asmodeus812/pillzmod/pcb-split/placement.png

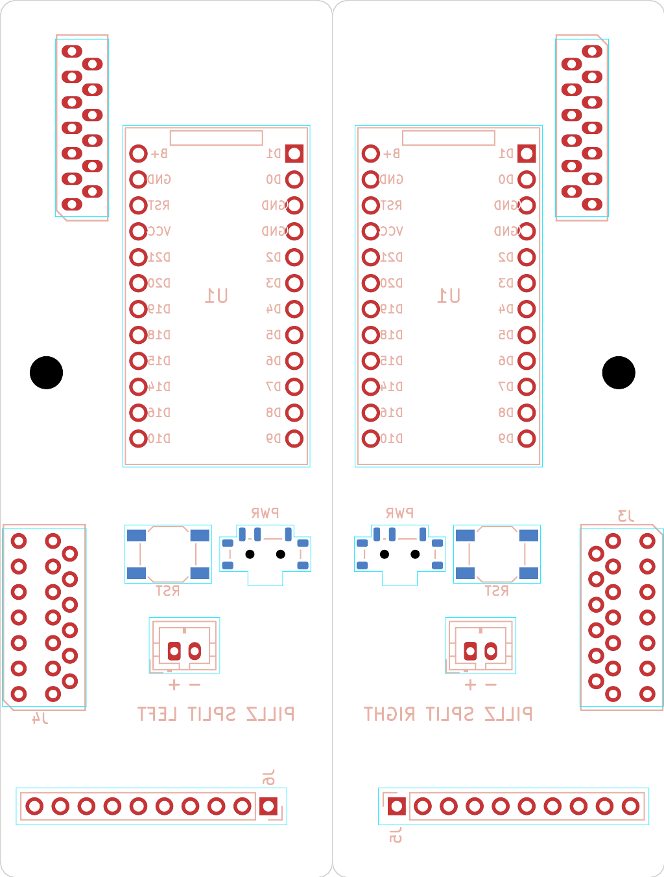
pcb-split/placement.png
