asmodeus812/pillzmod/pcb-split/routed.png

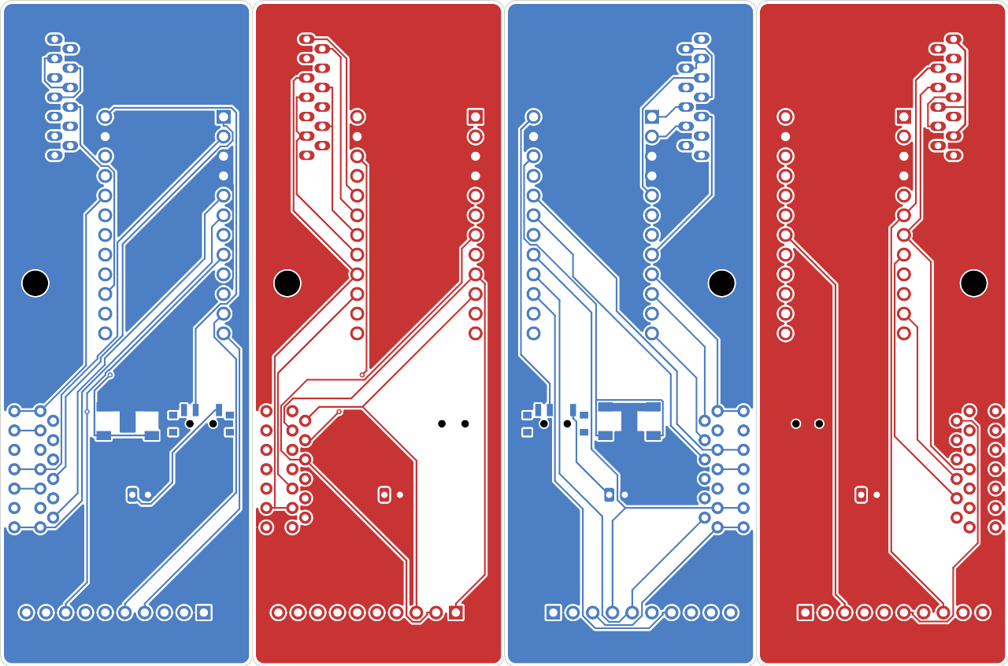
pcb-split/routed.png
