asmodeus812/pillzmod/pcb-split/parts-links.md

# Parts links (both halves, without the nice!nano, plus replacement cables)

Search links unless marked "product". Quantities are for both halves.

nice!nano sockets: one full 1x12 strip per side of each controller (4 strips),
plus 24 thin round male pins per controller (48). Mill-Max 315 low-profile
sockets take round pins of about 0.4-0.6 mm; square header pins don't fit.
3320-0-00-15-00-00-03-0 is the usual matching pin (unverified, check datasheet).

## DigiKey DE

Molex 39-53-2135 vertical, function row J1/J2 (x2): https://www.digikey.de/en/products/result?keywords=0039532135
Molex 39-53-2134 right angle, key well J3/J4 (x2): https://www.digikey.de/en/products/result?keywords=0039532134
JST B2B-PH-K-S (x2, product): https://www.digikey.de/en/products/detail/jst-sales-america-inc/B2B-PH-K-S/926611
Alps SKQGABE010 (x2): https://www.digikey.de/en/products/result?keywords=SKQGABE010
Mill-Max 315-43-112-41-003000 1x12 female socket strip (x4): https://www.digikey.de/en/products/result?keywords=315-43-112-41-003000
Mill-Max 3320-0-00-15-00-00-03-0 male pin, sold singly (x48): https://www.digikey.de/en/products/result?keywords=3320-0-00-15-00-00-03-0
1x10 pin header 2.54mm (x2): https://www.digikey.de/en/products/result?keywords=1x10%20pin%20header%202.54mm%20straight
C&K PCM12SMTR power switch (x2, product): https://www.digikey.de/en/products/detail/c-k/PCM12SMTR/1640112

## TME

Molex 39-53-2135 vertical, function row J1/J2 (x2): https://www.tme.eu/en/katalog/?search=39-53-2135
Molex 39-53-2134 right angle, key well J3/J4 (x2): https://www.tme.eu/en/katalog/?search=39-53-2134
JST B2B-PH-K-S (x2): https://www.tme.eu/en/katalog/?search=B2B-PH-K-S
Alps SKQGABE010 (x2): https://www.tme.eu/en/katalog/?search=SKQGABE010
Mill-Max 315-43-112-41-003000 1x12 female socket strip (x4): https://www.tme.eu/en/katalog/?search=315-43-112-41-003000
Mill-Max 3320-0-00-15-00-00-03-0 male pin, sold singly (x48): https://www.tme.eu/en/katalog/?search=3320-0-00-15-00-00-03-0
1x10 pin header 2.54mm (x2): https://www.tme.eu/en/katalog/?search=1x10%20pin%20header%202.54
C&K PCM12SMTR power switch (x2): https://www.tme.eu/en/katalog/?search=PCM12SMTR

## Mouser DE

Molex 39-53-2135 vertical, function row J1/J2 (x2): https://www.mouser.de/c/?q=0039532135
Molex 39-53-2134 right angle, key well J3/J4 (x2): https://www.mouser.de/c/?q=0039532134
JST B2B-PH-K-S (x2): https://www.mouser.de/c/?q=B2B-PH-K-S
Alps SKQGABE010 (x2): https://www.mouser.de/c/?q=SKQGABE010
Mill-Max 315-43-112-41-003000 1x12 female socket strip (x4): https://www.mouser.de/c/?q=315-43-112-41-003000
Mill-Max 3320-0-00-15-00-00-03-0 male pin, sold singly (x48): https://www.mouser.de/c/?q=3320-0-00-15-00-00-03-0
1x10 pin header 2.54mm (x2): https://www.mouser.de/c/?q=1x10%20header%202.54mm
C&K PCM12SMTR power switch (x2): https://www.mouser.de/c/?q=PCM12SMTR

## Farnell

Molex 39-53-2134 right angle, key well J3/J4 (x2, product): https://it.farnell.com/en-IT/molex-partner-stock/39-53-2134/fpc-conn-r-a-rcpt-13pos-1row-1/dp/4231522

## RS Components

Molex 39-53-2134 right angle, key well J3/J4 (x2, product): https://uk.rs-online.com/web/p/fpc-connectors/6704301

## Cables: key well / function row (13-pin flat flex, 1.25 mm pitch)

Only needed if the damaged flex unplugs at both ends; on the Advantage 2 the key
well flex is normally part of the key well. Measure the old one first: length,
and whether the contacts are on the same side at both ends (Type A) or opposite
sides (Type D). DigiKey lists 15168-xx13 as "top on both sides" = check before buying.
DigiKey .de links below are built from the product numbers seen on other DigiKey regions.

Molex 0151680813, 13 pos, 2 in / 50.8 mm (DigiKey, product): https://www.digikey.de/en/products/detail/molex/0151680813/4426889
Molex 0151680815, 13 pos, 3 in / 76.2 mm (DigiKey, product): https://www.digikey.de/en/products/detail/molex/0151680815/4143332
Molex 0151680821, 13 pos, 6 in / 152.4 mm (DigiKey, product): https://www.digikey.de/en/products/detail/molex/0151680821/4426892
Molex 151680813 product page (drawing, contact type): https://www.molex.com/en-us/products/part-detail/151680813
Molex 15168 13 pos, all lengths (Mouser): https://www.mouser.de/c/?q=15168%2013%20position
1.25 mm 13 pin FFC, all brands (TME): https://www.tme.eu/en/katalog/?search=FFC%201.25%2013

## Cables: thumb clusters (10-wire, 2.54 mm, single-row 1x10 both ends)

Pillz thumb PCB uses a 1x10 single-row header, not 2x5 IDC. Either a ready
10-wire Dupont female-female ribbon (peel 10 off a 40-wire strip) or KF2510
housings + crimp pins + ribbon. 10 cm is enough (upstream says >= 50 mm).

Dupont jumper ribbon F-F 10 cm (Botland): https://botland.com.pl/en/search?s=jumper%20wires%20female%20female%2010cm
Dupont jumper ribbon F-F 10 cm (Reichelt): https://www.reichelt.de/index.html?ACTION=446&SEARCH=jumper%20female%20female%2010cm
1x10 Dupont housing 2.54 mm (TME): https://www.tme.eu/en/katalog/?search=1x10%20housing%202.54
KF2510-10 housing (TME): https://www.tme.eu/en/katalog/?search=KF2510
1x10 female-female jumper 2.54 mm (DigiKey): https://www.digikey.de/en/products/result?keywords=jumper%20wire%20female%20female%2010%20position%202.54
