asmodeus812/pillzmod/pcb-split/right/pillz_split_right.kicad_pcb

## KiCad design pcb-split/right/pillz_split_right.kicad_pcb (2026-10-31)

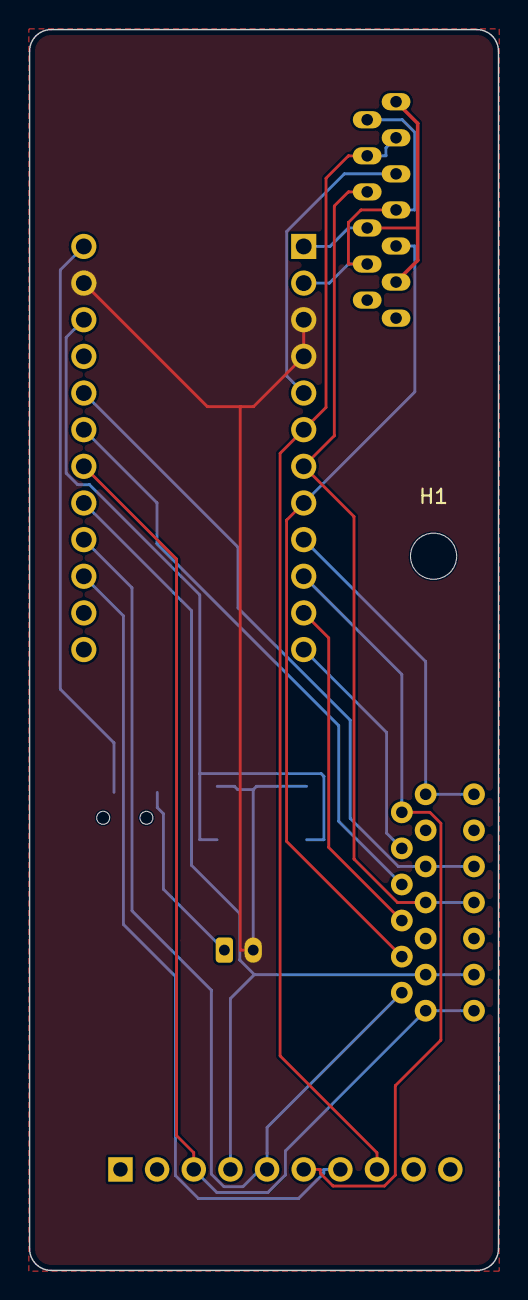
[picture p5: board pillz_split_right.kicad_pcb from above]

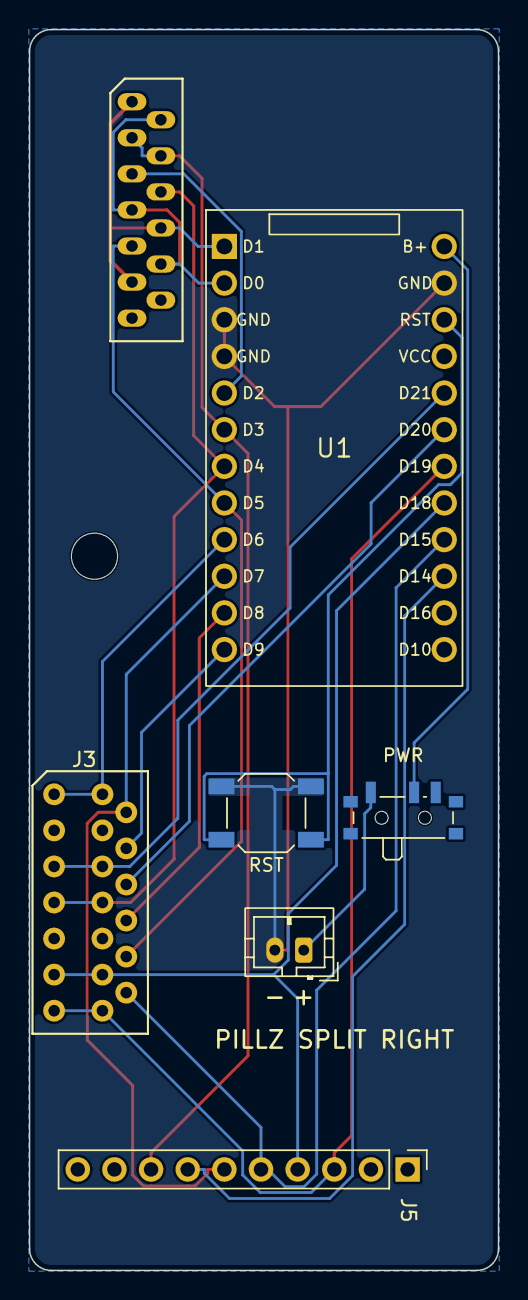
[picture p6: board pillz_split_right.kicad_pcb from below]

Board: 2 copper layers, 32.5 x 86.0 mm, 8 parts (7 on the bottom side), 20 nets.

Parts:
H1: MountingHole_3.2mm_M3
J1: Conn_01x13; Molex_0039532135
J3: Conn_01x13; Molex_039532134
J5: Conn_01x10; PinHeader_1x10_PillzThumb
J7: JST_PH_B2B-PH-K_1x02_P2.00mm_Vertical
SW1: SW_SPST_SKQG_WithoutStem
SW2: SW_SPDT_PCM12
U1: nice!nano v2; nice_nano_v2

Connections:
B+: SW2.2, U1.24
BAT+: J7.1, SW2.1
COL_0: J3.4, U1.12
COL_1: J3.5, U1.20
COL_2: J3.6, U1.19
COL_3: J1.6, J3.7, U1.7
COL_4: J1.9, J3.10, U1.8
COL_5: J1.3, J1.4, J5.8, U1.6
COL_6: J5.7, U1.15
GND: J7.2, SW1.2, U1.3, U1.4, U1.23
ROW_6: J3.13, J5.3, U1.18
ROW_7: J3.11, J5.4, U1.17
ROW_8: J3.12, J5.5, U1.16
ROW_9: J3.2, J5.6, U1.10
ROW_10: J3.1, U1.9
ROW_11: J3.8, U1.11
ROW_12: J1.5, U1.5
ROW_13: J1.1, J1.8, J1.11, U1.1
ROW_14: J1.2, J1.7, J1.10, U1.2
RST: SW1.1, U1.22
