asmodeus812/pillzmod/pcb-split/left/pillz_split_left.kicad_pcb

## KiCad design pcb-split/left/pillz_split_left.kicad_pcb (2026-10-31)

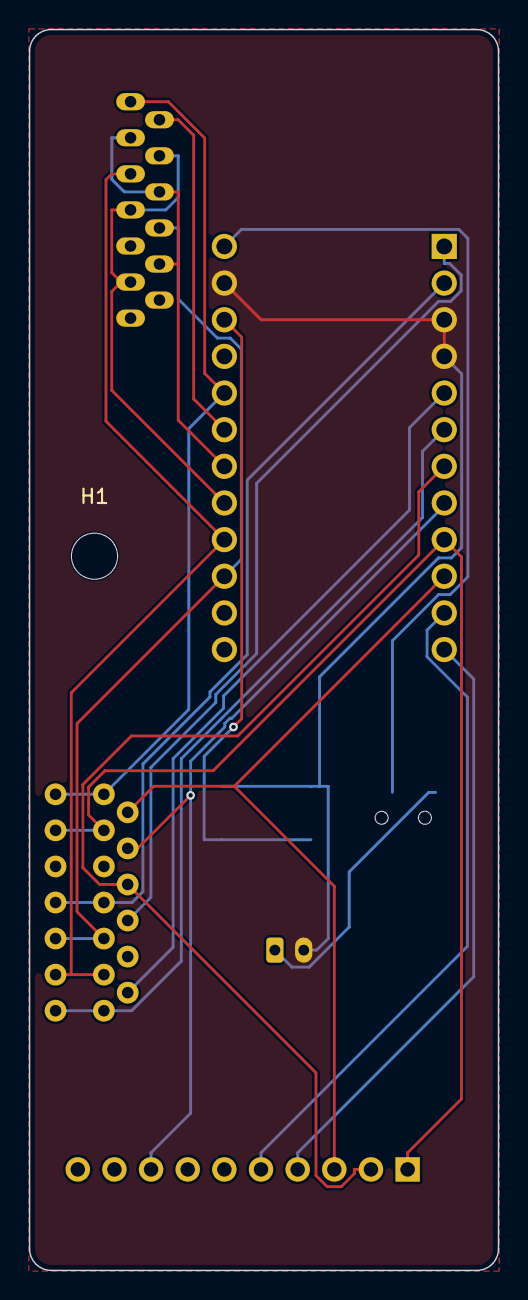
[picture p7: board pillz_split_left.kicad_pcb from above]

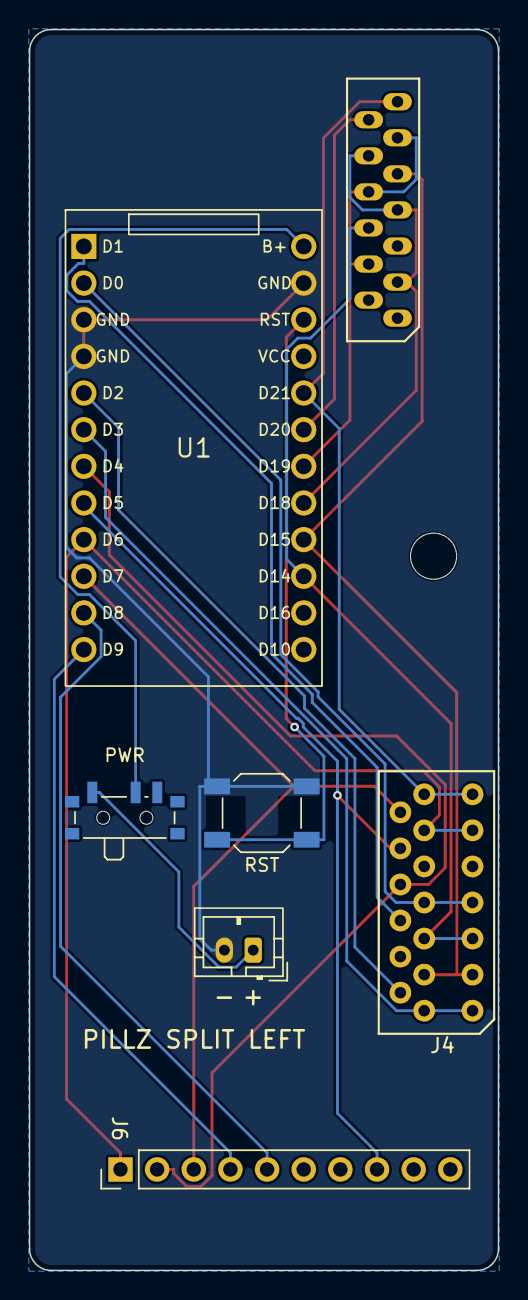
[picture p8: board pillz_split_left.kicad_pcb from below]

Board: 2 copper layers, 32.5 x 86.0 mm, 8 parts (7 on the bottom side), 20 nets.

Parts:
H1: MountingHole_3.2mm_M3
J2: Conn_01x13; Molex_0039532135
J4: Conn_01x13; Molex_039532134
J6: Conn_01x10; PinHeader_1x10_PillzThumb
J7: JST_PH_B2B-PH-K_1x02_P2.00mm_Vertical
SW1: SW_SPST_SKQG_WithoutStem
SW2: SW_SPDT_PCM12
U1: nice!nano v2; nice_nano_v2

Connections:
B+: SW2.2, U1.24
BAT+: J7.1, SW2.1
COL_0: J2.13, J4.13, U1.20
COL_1: J2.6, J4.5, U1.15
COL_2: J2.9, J4.3, U1.16
COL_3: J4.2, U1.5
COL_4: J4.1, U1.6
COL_5: J6.5, U1.11
COL_6: J6.4, U1.12
GND: J7.2, SW1.2, U1.3, U1.4, U1.23
ROW_0: J4.6, U1.1
ROW_1: J4.7, U1.2
ROW_2: J4.8, J6.2, U1.7
ROW_3: J4.10, J6.8, U1.8
ROW_4: J4.11, J6.1, U1.9
ROW_5: J4.12, J6.3, U1.10
ROW_12: J2.12, U1.19
ROW_13: J2.4, J2.8, J2.11, U1.18
ROW_14: J2.3, J2.7, J2.10, U1.17
RST: SW1.1, U1.22
