asmodeus812/pillzmod/(commit log)

2026-10-31 Add split PCB for a physically split Kinesis Advantage 2
    Two narrow boards, one per half, derived from pcb-pro. Each has its own
    nice!nano, power switch, reset button and JST-PH battery socket, and the
    matrix is wired straight to the controller (9 rows + 7 cols per half), so
    the 74HC595 is gone.
    Connector footprints and positions are copied verbatim from pcb-pro so
    the key-well flex cables and Pillz thumb ribbons reach them unchanged;
    gen.py fails if any pad moves. build.sh autoroutes with Freerouting,
    pours GND, runs DRC and exports Gerbers. 3D renders use stock KiCad
    models plus approximate box models from models.py.
    [pillz_split_left-B_Cu.gbl, pillz_split_left-B_Mask.gbs, pillz_split_left-B_Paste.gbp, pillz_split_left-B_Silkscreen.gbo, pillz_split_left-Edge_Cuts.gm1, pillz_split_left-F_Cu.gtl, pillz_split_left-F_Mask.gts, pillz_split_left-F_Paste.gtp]
2026-10-31 Show split PCB renders as seen from underneath
    The renders look at the component side, which faces down in the case, so
    put the right half on the left and say so in the READMEs.
2026-10-31 Use an EU-stocked power switch on the split PCB
    Swap the MSK12C02 (only sold via LCSC) for the C&K PCM12SMTR, which has
    the same signal pin positions and a stock KiCad 3D model. Re-route both
    halves, retrying in build.sh when Freerouting leaves a net unrouted, and
    lock the one ROW_13 link on J1 it never finds. Add parts-links.md with EU
    vendor links for all parts and the replacement cables.
    [pillz_split_left-B_Cu.gbl, pillz_split_left-B_Mask.gbs, pillz_split_left-B_Paste.gbp, pillz_split_left-B_Silkscreen.gbo, pillz_split_left-Edge_Cuts.gm1, pillz_split_left-F_Cu.gtl, pillz_split_left-F_Mask.gts, pillz_split_left-F_Paste.gtp]
